quangphamhcmut/Embedded-Systems.Project-Smart-Key/firmware_flowchart.drawio.png

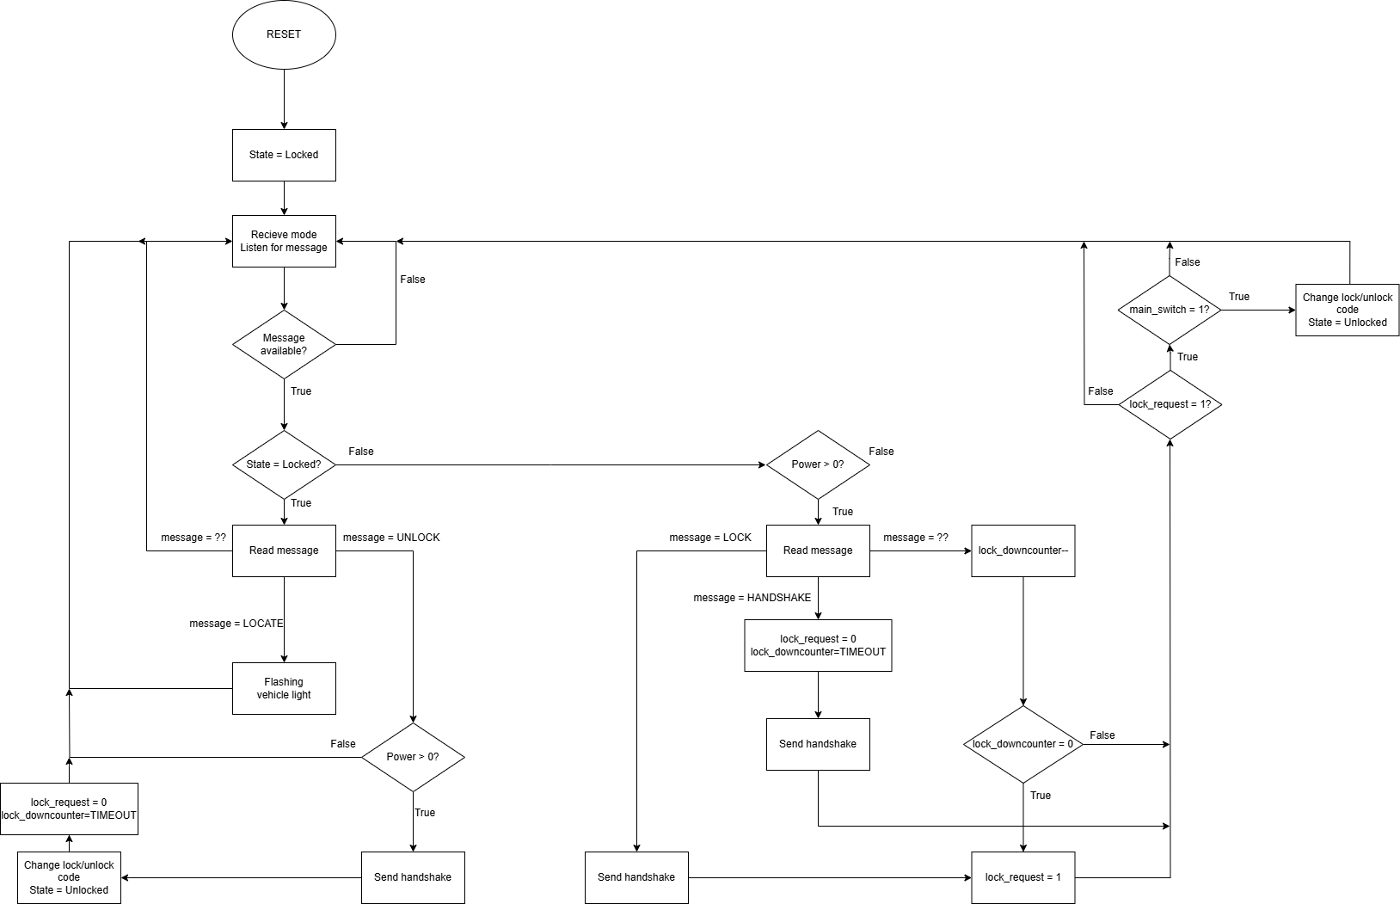
firmware_flowchart.drawio.png
