quangphamhcmut/Embedded-Systems.Project-Smart-Key/smartkey_system_schematic_rev1.0.pdf

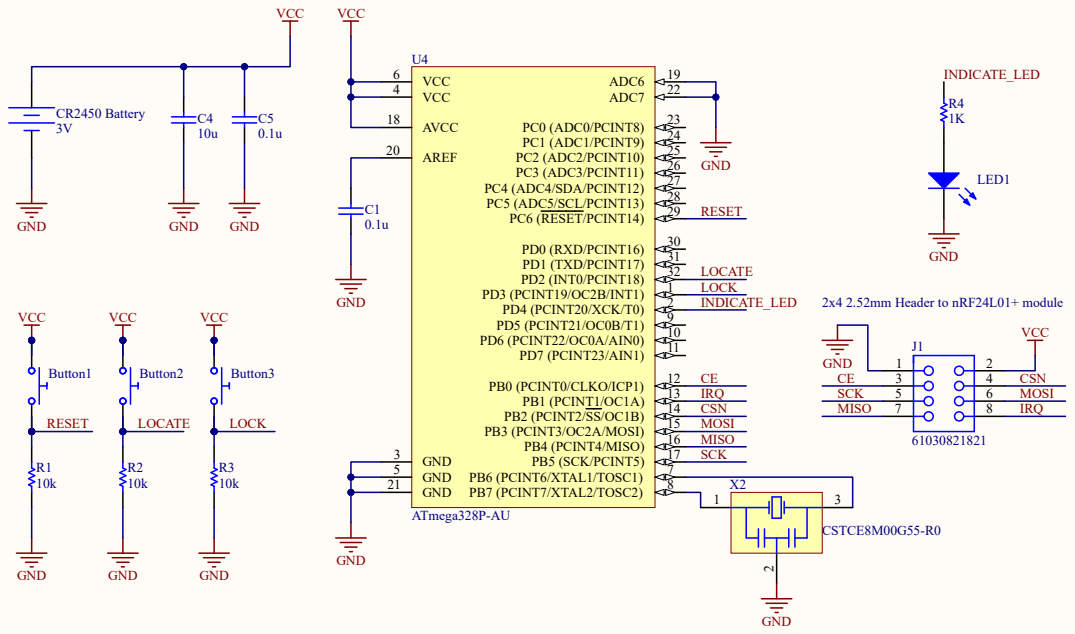
[picture p24: page 1]

SS14 1 2

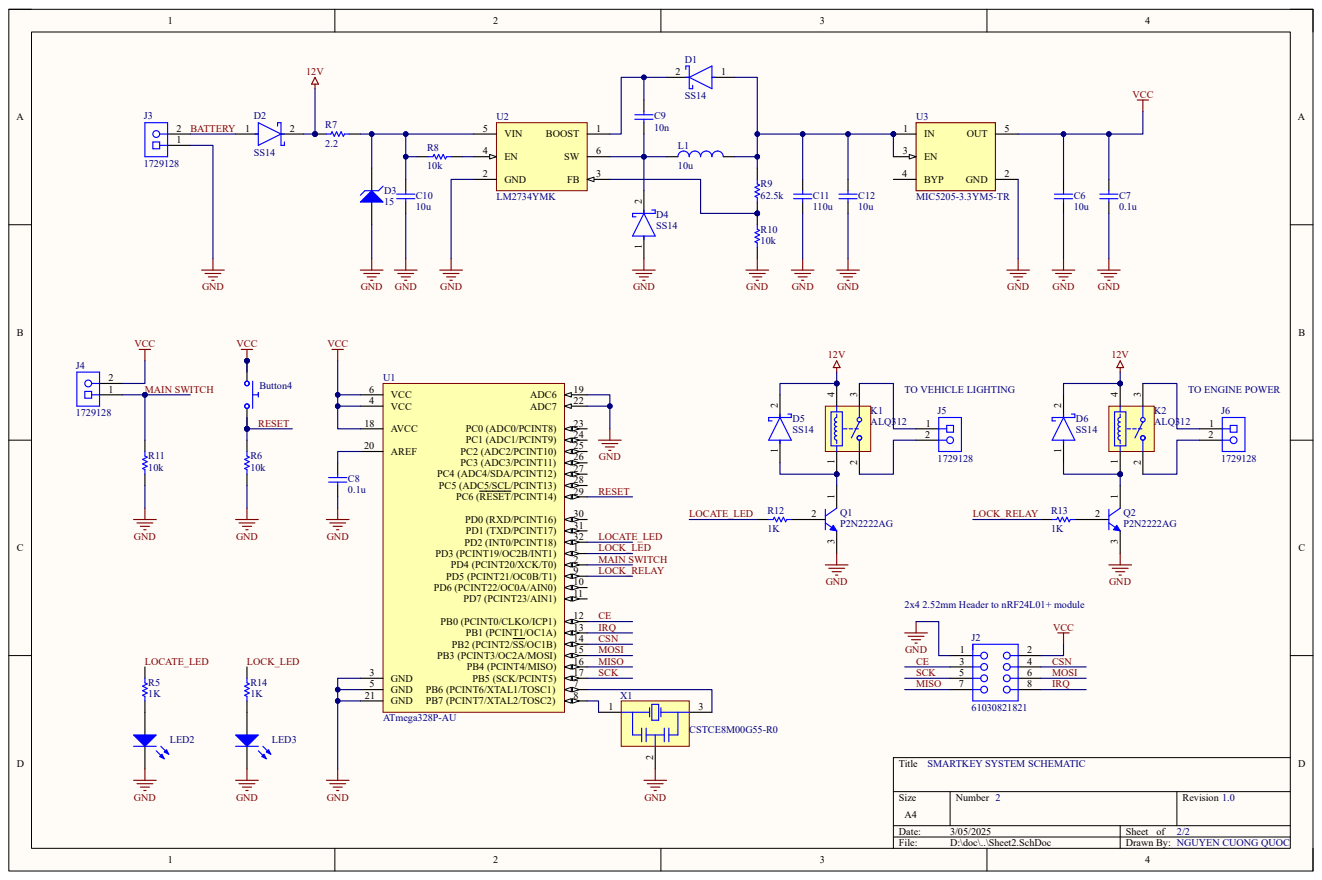
[picture p25: page 2]
