quangphamhcmut/Embedded-Systems.Project-Smart-Key/pcb_kicad_project/Keyfob/KiCad_9_Key_fob_project-B_Cu.pdf

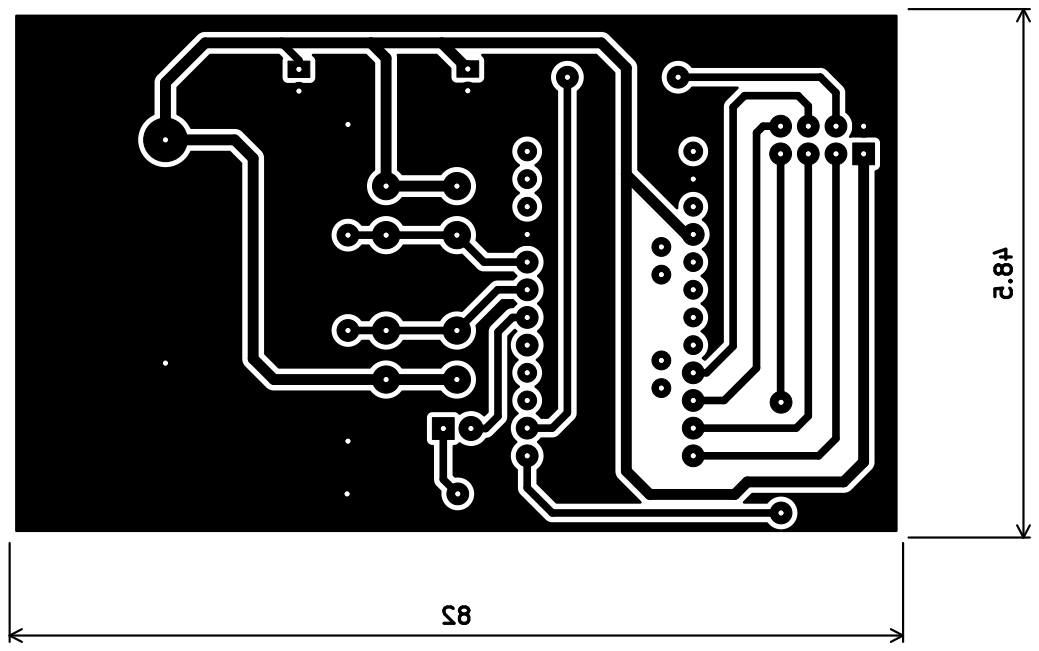
[picture p26: page 1]
