quangphamhcmut/Embedded-Systems.Project-Smart-Key/pcb_kicad_project/Receiver/Receiver-B_Cu.pdf

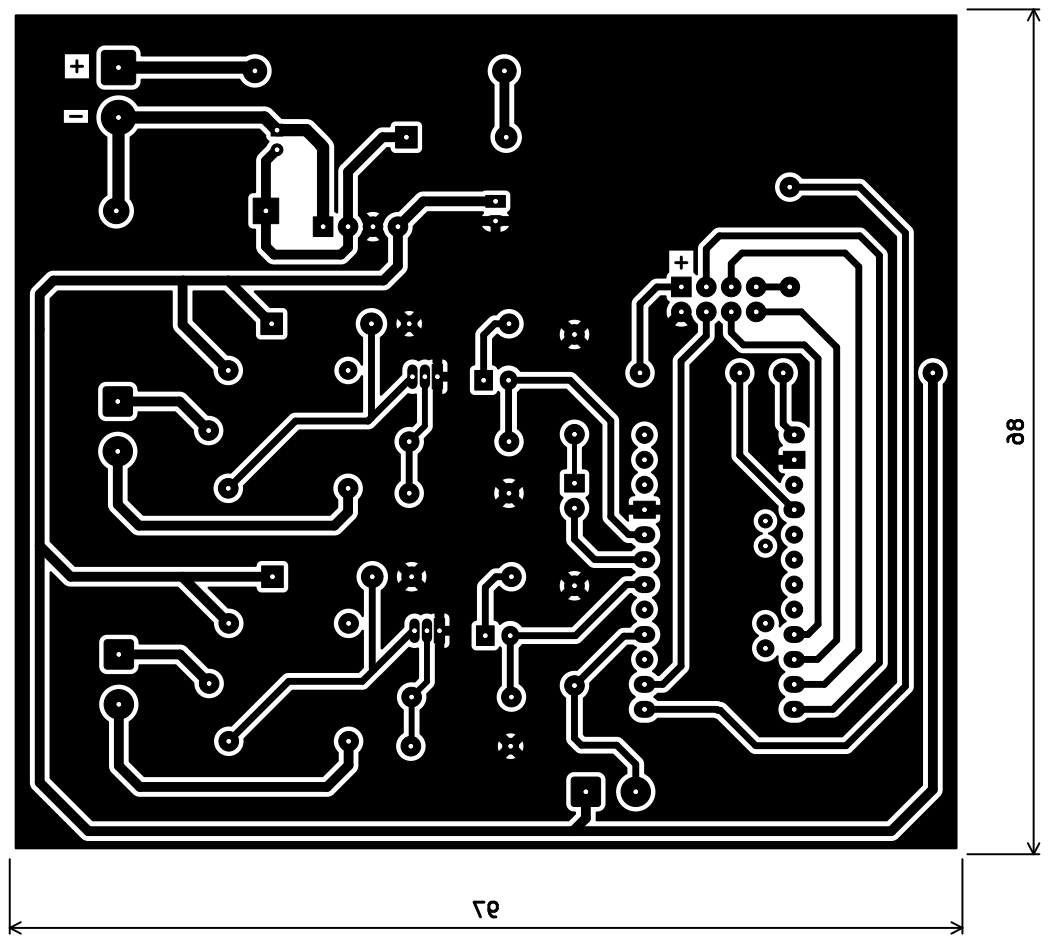
[picture p27: page 1]
