quangphamhcmut/Embedded-Systems.Project-Smart-Key/(list of files, drawings)

Other design files:
key_altium_project/Key_Project/ARDUINO_PRO_MINI/ARDUINO_PRO_MINI.SchLib
key_altium_project/Key_Project/ARDUINO_PRO_MINI/MODULE_ARDUINO_PRO_MINI.PcbLib
key_altium_project/Key_Project/KEY_PCB.SchDoc
key_altium_project/Key_Project/Key_Project.PrjPcb
key_altium_project/Key_Project/KEY_RAW_SCH.SchDoc
key_altium_project/Key_Project/VEHICLE_RAW_SCH.SchDoc
