quangphamhcmut/Embedded-Systems.Project-Smart-Key/pcb_kicad_project/Keyfob/Keyfob.kicad_pcb

## KiCad design pcb_kicad_project/Keyfob/Keyfob.kicad_pcb (2025-05-07)

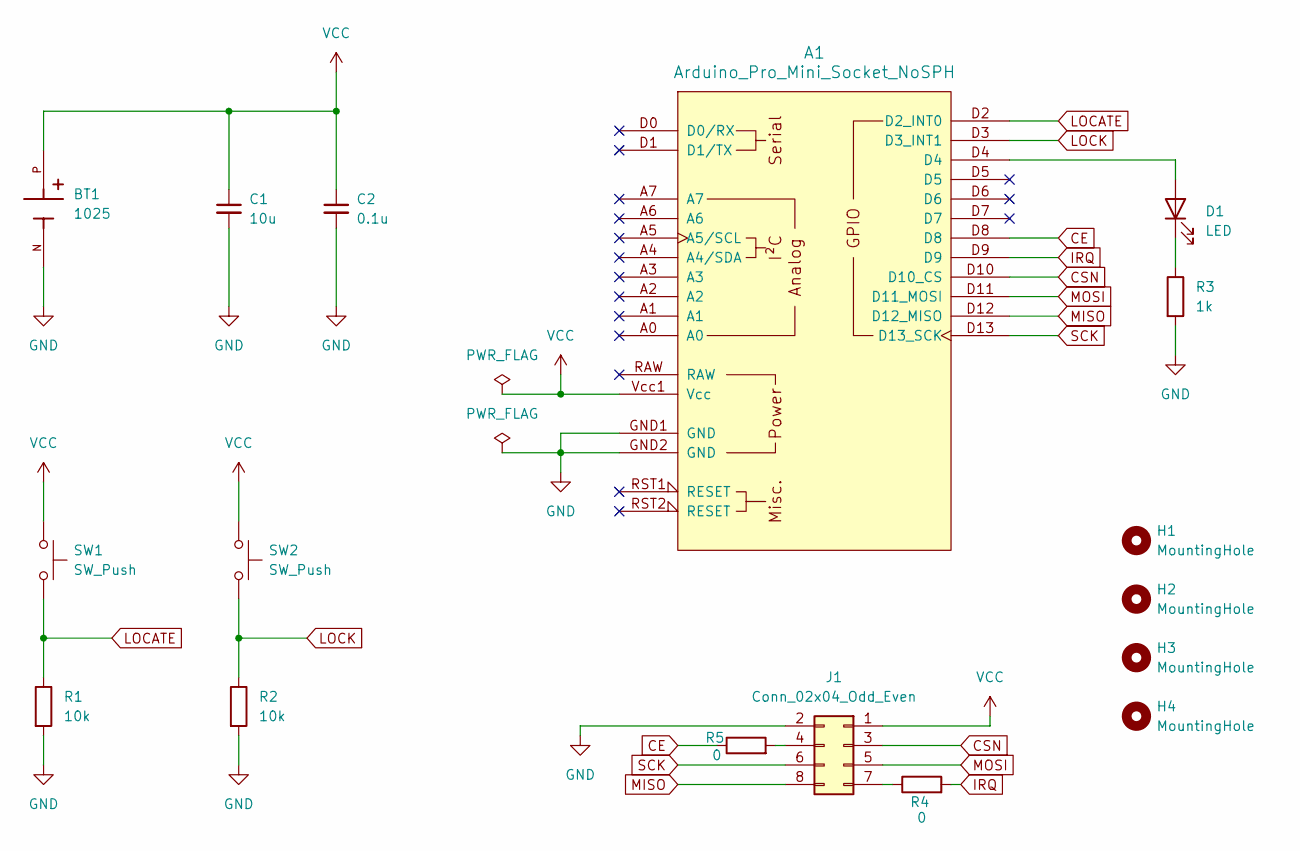
[picture p28: schematic Keyfob.kicad_sch, Smart Key System - Key Fob]

Parts:
A1: Arduino_Pro_Mini_Socket_NoSPH
BT1: 1025; BAT_1025; PARTREV H
C1: 10u; CP_Radial_D4.0mm_P2.00mm
C2: 0.1u; CP_Radial_D4.0mm_P2.00mm
D1: LED; LED_D3.0mm
H1, H2, H3, H4: MountingHole; MountingHole_3.2mm_M3
J1: Conn_02x04_Odd_Even; PinSocket_2x04_P2.54mm_Vertical
R1, R2: 10k; R_Axial_DIN0207_L6.3mm_D2.5mm_P10.16mm_Horizontal
R3: 1k; R_Axial_DIN0207_L6.3mm_D2.5mm_P10.16mm_Horizontal
R4, R5: 0; R_Axial_DIN0207_L6.3mm_D2.5mm_P10.16mm_Horizontal
SW1, SW2: SW_Push; SW_PUSH_6mm

Connections:
CE: A1.D8, R5.1
CSN: A1.D10 (D10_CS), J1.3
GND: A1.GND1 (GND), A1.GND2 (GND), BT1.N, C1.2, C2.2, J1.2, R1.2, R2.2, R3.2
IRQ: A1.D9, R4.2
LOCATE: A1.D2 (D2_INT0), R1.1, SW1.2
LOCK: A1.D3 (D3_INT1), R2.1, SW2.2
MISO: A1.D12 (D12_MISO), J1.8
MOSI: A1.D11 (D11_MOSI), J1.5
unnamed: A1.D4, D1.2 (A)
unnamed: D1.1 (K), R3.1
unnamed: J1.4, R5.2
unnamed: J1.7, R4.1
SCK: A1.D13 (D13_SCK), J1.6
VCC: A1.Vcc1 (Vcc), BT1.P, C1.1, C2.1, J1.1, SW1.1, SW2.1

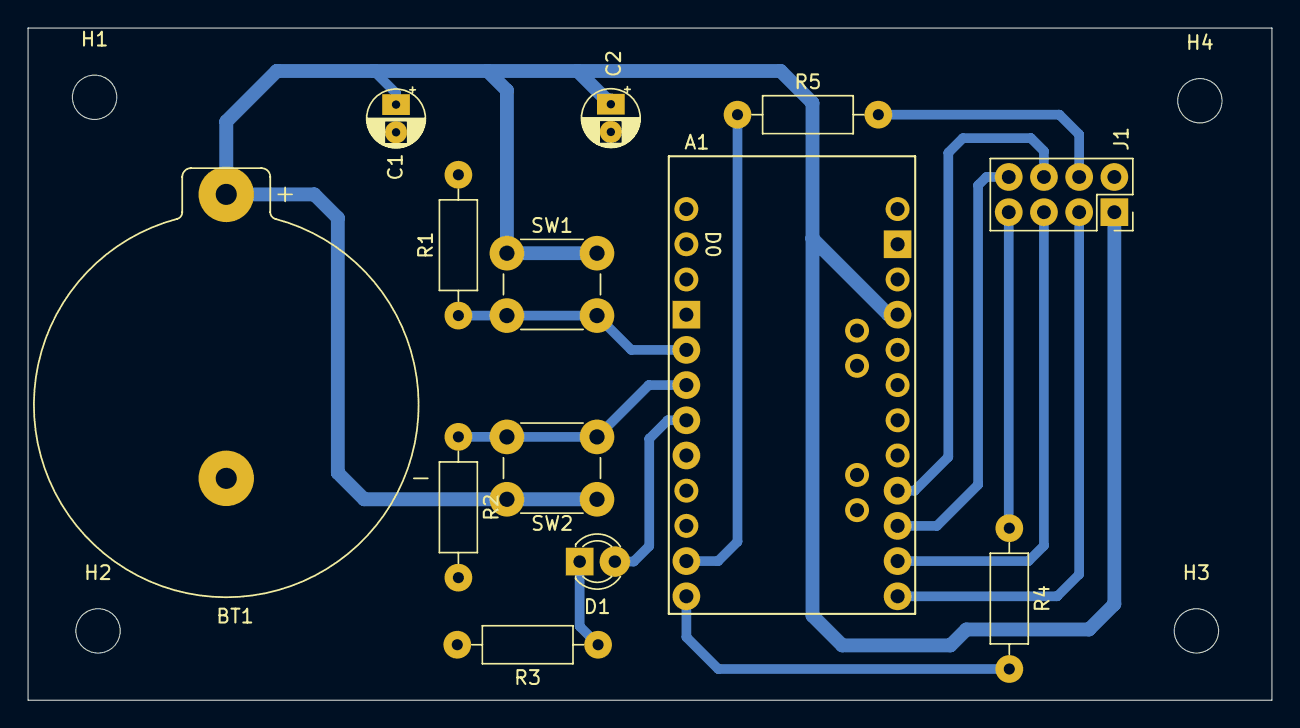
[picture p29: board Keyfob.kicad_pcb from above]

Board: 2 copper layers, 89.7 x 48.5 mm, 17 parts (0 on the bottom side), 14 nets.
