quangphamhcmut/Embedded-Systems.Project-Smart-Key/pcb_kicad_project/Receiver/Receiver.kicad_pcb

## KiCad design pcb_kicad_project/Receiver/Receiver.kicad_pcb (2025-05-07)

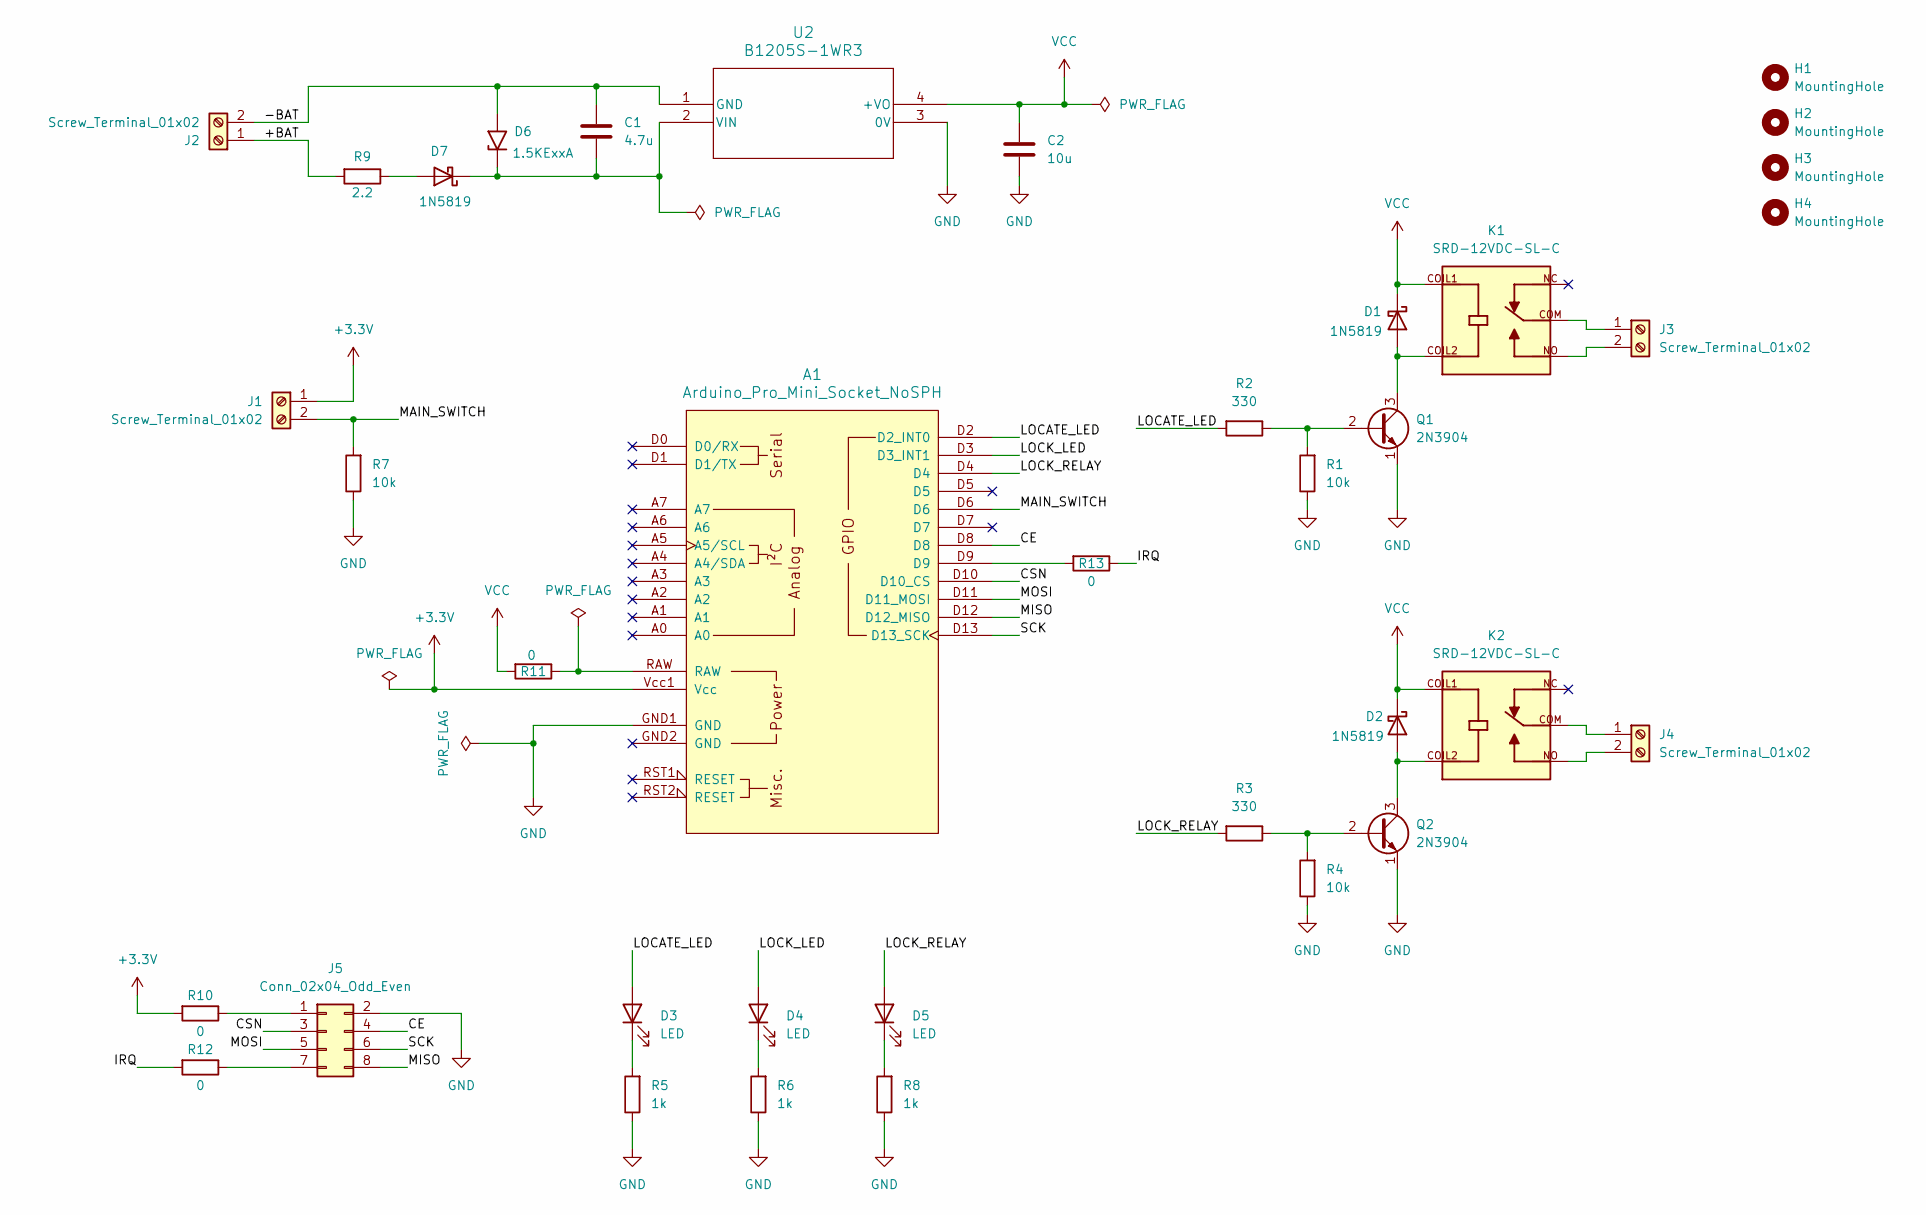
[picture p30: schematic Receiver.kicad_sch, Smart Key System - Receiver]

Parts:
A1: Arduino_Pro_Mini_Socket_NoSPH
C1: 4.7u; CP_Radial_D4.0mm_P2.00mm
C2: 10u; CP_Radial_D4.0mm_P2.00mm
D1, D2, D7: 1N5819; D_DO-41_SOD81_P10.16mm_Horizontal
D3, D4, D5: LED; LED_D3.0mm
D6: 1.5KExxA; D_DO-201AE_P15.24mm_Horizontal
H1, H2, H3, H4: MountingHole; MountingHole_3.2mm_M3
J1, J2, J3, J4: Screw_Terminal_01x02; TerminalBlock_CUI_TB007-508-02_1x02_P5.08mm_Horizontal
J5: Conn_02x04_Odd_Even; PinSocket_2x04_P2.54mm_Vertical
K1, K2: SRD-12VDC-SL-C; RELAY_SRD-12VDC-SL-C; PARTREV 1.0
Q1, Q2: 2N3904; TO-92_Inline
R1, R4, R7: 10k; R_Axial_DIN0207_L6.3mm_D2.5mm_P10.16mm_Horizontal
R2, R3: 330; R_Axial_DIN0207_L6.3mm_D2.5mm_P10.16mm_Horizontal
R5, R6, R8: 1k; R_Axial_DIN0207_L6.3mm_D2.5mm_P10.16mm_Horizontal
R9: 2.2; R_Axial_Power_L20.0mm_W6.4mm_P25.40mm
R10, R12, R13: 0; R_Axial_DIN0207_L6.3mm_D2.5mm_P10.16mm_Horizontal
R11: 0; R_Axial_DIN0207_L6.3mm_D2.5mm_P15.24mm_Horizontal
U2: B1205S-1WR3; SIP4_B_S-1WR3_MNS

Connections:
+3.3V: A1.Vcc1 (Vcc), J1.1, R10.2
/+BAT: J2.1, R9.2
/-BAT: C1.1, D6.2 (A2), J2.2, U2.1 (GND)
/CE: A1.D8, J5.4
/CSN: A1.D10 (D10_CS), J5.3
/IRQ: R12.2, R13.1
/LOCATE_LED: A1.D2 (D2_INT0), D3.2 (A), R2.2
/LOCK_LED: A1.D3 (D3_INT1), D4.2 (A)
/LOCK_RELAY: A1.D4, D5.2 (A), R3.2
/MAIN_SWITCH: A1.D6, J1.2, R7.2
/MISO: A1.D12 (D12_MISO), J5.8
/MOSI: A1.D11 (D11_MOSI), J5.5
/SCK: A1.D13 (D13_SCK), J5.6
GND: A1.GND1 (GND), C2.2, J5.2, Q1.1 (E), Q2.1 (E), R1.1, R4.1, R5.1, R6.1, R7.1, R8.1, U2.3 (0V)
unnamed: A1.D9, R13.2
unnamed: A1.RAW, R11.1
unnamed: D1.2 (A), K1.COIL2, Q1.3 (C)
unnamed: D2.2 (A), K2.COIL2, Q2.3 (C)
unnamed: D3.1 (K), R5.2
unnamed: D4.1 (K), R6.2
unnamed: D5.1 (K), R8.2
unnamed: C1.2, D6.1 (A1), D7.1 (K), U2.2 (VIN)
unnamed: D7.2 (A), R9.1
unnamed: J3.1, K1.COM
unnamed: J3.2, K1.NO
unnamed: J4.1, K2.COM
unnamed: J4.2, K2.NO
unnamed: J5.1, R10.1
unnamed: J5.7, R12.1
unnamed: Q1.2 (B), R1.2, R2.1
unnamed: Q2.2 (B), R3.1, R4.2
VCC: C2.1, D1.1 (K), D2.1 (K), K1.COIL1, K2.COIL1, R11.2, U2.4 (+VO)

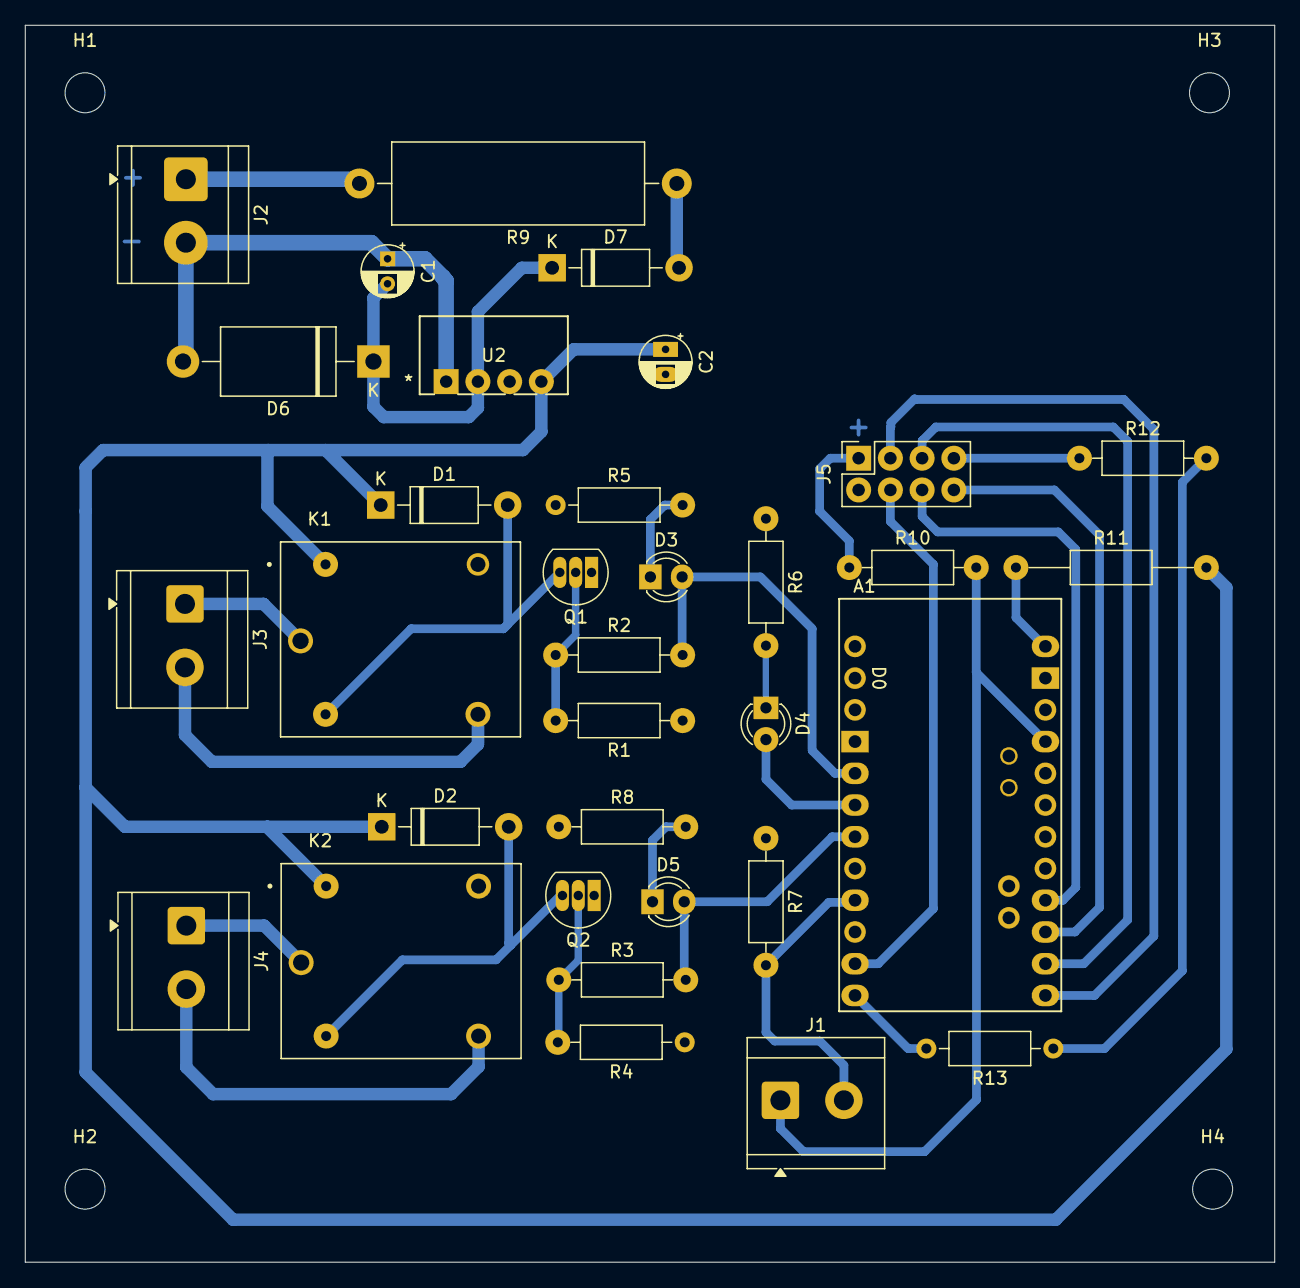
[picture p31: board Receiver.kicad_pcb from above]

Board: 2 copper layers, 100.0 x 99.0 mm, 37 parts (0 on the bottom side), 32 nets.
