quangphamhcmut/Embedded-Systems.Project-Smart-Key/core_code/key/QoL.h

/*
 * QoL.h
 *
 * Created: 22/04/2025 22:36:14
 *  Author: Admin
 */ 


#ifndef QOL_H_
#define QOL_H_

#define setbit(port, bit) (port) |= (1 << (bit))
#define clearbit(port, bit) (port) &= ~(1 << (bit))

#endif /* QOL_H_ */
