quangphamhcmut/Embedded-Systems.Project-Smart-Key/(commit log)

2025-02-15 update battery
2025-04-02 update project file
    [ARDUINO_PRO_MINI.SchLib, KEY_PCB.SchDoc, KEY_RAW_SCH.SchDoc, Key_Project.PrjPcb, MODULE_ARDUINO_PRO_MINI.PcbLib, VEHICLE_RAW_SCH.SchDoc]
2025-04-02 update pcb project file
    [KEY_PCB.SchDoc, Key_Project.PrjPcb]
2025-04-02 update pcb project
    [KEY_RAW_SCH.SchDoc, VEHICLE_RAW_SCH.SchDoc]
2025-05-07 add KiCAD PCB projects
    [Keyfob.kicad_pcb, Keyfob.kicad_sch, Receiver.kicad_pcb, Receiver.kicad_sch]
2025-05-07 update schematic
    [Keyfob.kicad_sch, Receiver.kicad_sch]
2025-05-07 update flowchart
